Armlatable/Armlatable/docs/構成図.png

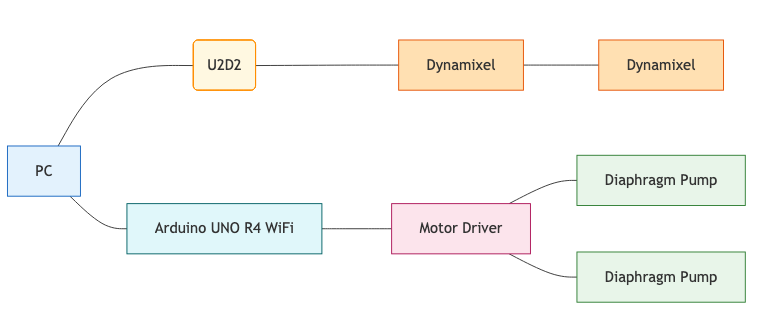
docs/構成図.png
