Armlatable/Armlatable/circuit/armlatable_v1/armlatable_v1.kicad_pcb

## KiCad design circuit/armlatable_v1/armlatable_v1.kicad_pcb (2026-02-26)

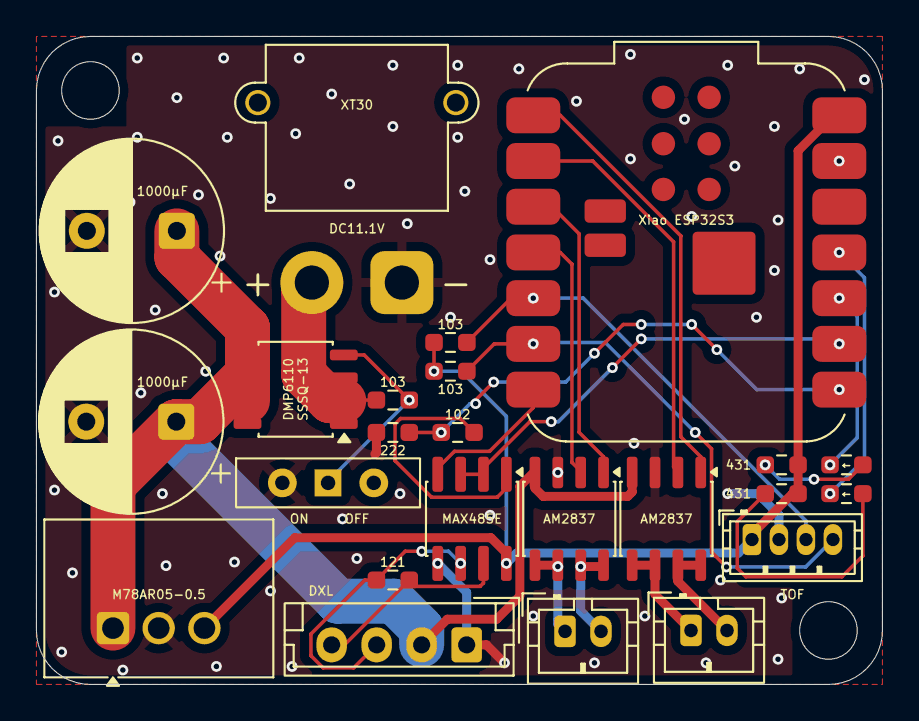
[picture p2: board armlatable_v1.kicad_pcb from above]

Board: 2 copper layers, 47.0 x 36.0 mm, 24 parts (0 on the bottom side), 25 nets.

Parts:
102: 1kΩ; R_0603_1608Metric_Pad0.98x0.95mm_HandSolder
103, 103#2: 10kΩ; R_0603_1608Metric_Pad0.98x0.95mm_HandSolder
121: 120Ω; R_0603_1608Metric_Pad0.98x0.95mm_HandSolder
AM2837: SO-8_3.9x4.9mm_P1.27mm
C1, C2: 1000μF; CP_Radial_D10.0mm_P5.00mm
D1, D2: LED; R_0603_1608Metric_Pad0.98x0.95mm_HandSolder
DMP6110: Q_Dual_PMOS_S1G1S2G2D2D2D1D1; SSOP-8_3.9x5.05mm_P1.27mm
J2: Xiao ESP32S3; MCU_Seeed_ESP32C3
J3: DXL; JST_EH_B4B-EH-A_1x04_P2.50mm_Vertical
J4: Conn_01x04_Socket; JST_ZH_B4B-ZR_1x04_P1.50mm_Vertical
J6, J7: Conn_01x02_Socket; JST_PH_B2B-PH-K_1x02_P2.00mm_Vertical
M78AR05-0.5: TSR0.5-2450; Converter_DCDC_TRACO_TSR0.5-24xx_TSR0.5-24xxx_THT
ON: SW_SPDT; SW_Slide-03_Wuerth-WS-SLTV_10x2.5x6.4_P2.54mm
R1: 103; R_0603_1608Metric_Pad0.98x0.95mm_HandSolder
R3: 2.2kΩ; R_0603_1608Metric_Pad0.98x0.95mm_HandSolder
R7, R8: 430Ω; R_0603_1608Metric_Pad0.98x0.95mm_HandSolder
U2: MAX485E; SOIC-8_3.9x4.9mm_P1.27mm
U6: SO-8_3.9x4.9mm_P1.27mm
XT30: Conn_01x02_Pin; AMASS_XT30PW-M_1x02_P2.50mm_Horizontal

Connections:
+5V: 103.2, 103#2.1, J2.14, J4.1, M78AR05-0.5.3 (Vout), R7.2, R8.2, U2.8 (VCC)
+12V: AM2837.4 (VCC), C1.1, C2.1, DMP6110.7 (D), DMP6110.8 (D), J3.2, M78AR05-0.5.1 (Vin), U6.4 (VCC)
GND: AM2837.3 (GND), C1.2, C2.2, J2.13, J3.1, J4.2, M78AR05-0.5.2 (GND), ON.2 (B), R3.2, U2.5 (GND), U6.3 (GND), XT30.2
MD1INA: AM2837.1 (IN_A), J2.3
MD1INB: AM2837.2 (IN_B), J2.4
MD2INA: J2.1, U6.1 (IN_A)
MD2INB: J2.2, U6.2 (IN_B)
unnamed: D1.2 (A), R7.1
unnamed: D1.1 (K), J2.11
unnamed: D2.2 (A), R8.1
unnamed: D2.1 (K), J2.10
unnamed: DMP6110.1 (S), R1.2, XT30.1
unnamed: 121.1, J3.3, U2.6 (A)
unnamed: 121.2, J3.4, U2.7 (B)
unnamed: AM2837.7 (OUT_A), AM2837.8 (OUT_A), J6.1
unnamed: AM2837.5 (OUT_B), AM2837.6 (OUT_B), J6.2
unnamed: J7.1, U6.7 (OUT_A), U6.8 (OUT_A)
unnamed: J7.2, U6.5 (OUT_B), U6.6 (OUT_B)
unnamed: DMP6110.2 (G), ON.1 (A), R1.1
unnamed: 102.1, U2.1 (RO)
RDE: J2.9, U2.2 (~RE), U2.3 (DE)
RX: 102.2, J2.8, R3.1
SCL: 103#2.2, J2.6, J4.4
SDA: 103.1, J2.5, J4.3
TX: J2.7, U2.4 (DI)
