Armlatable/Armlatable/(commit log)

2025-12-25 feat: dc_motor, dynamixelの制御コードを実装 (#2)
2026-01-15 Feat/proto control (#3)
    * feat: dc_motor, dynamixelの制御コードを実装
    * feat: keyboard操作を追加
2026-02-01 Add armlatable main pcb
    [armlatable_v1.kicad_pcb, armlatable_v1.kicad_sch]
2026-02-01 Modify silks
    [armlatable_v1.kicad_pcb]
2026-02-08 feat: dynamixelの複数動作に対応
2026-02-08 feat: dcmotor_driverを複数動作に対応, r4へ
2026-02-08 feat: make installをwslに対応
2026-02-08 feat: usb_pathの自動確認を追加
2026-02-08 fix: wslのバグ抑制
2026-02-26 fix: Modify circuit
2026-03-07 docs: 構成図の追加
2026-03-07 docs: 構成図にarduino_unoを追加
